amberchild/MPPT-Solar-Charger/Documents/MPPT_Charger_BOM_v1.xls

MPPT Charger BOM
Part Description | Designator | Value | Footprint | Specification | Quantity | Manufacturer | Manufacturer Part No. | Supplier | Supplier part number | Link
Ceramic Capacitor | C1, C2, C3, C4, C9, C13, C14, C15, C20, C21, C22, C23, C24, C25, C26, C28, C32 | 100nF | C0402 | X7R, 35V, 10% | 17 | TDK Corporation | CGA2B3X7R1V104K050BB | DigiKey | 445-6901-1-ND | https://www.digikey.com/product-detail/en/tdk-corporation/CGA2B3X7R1V104K050BB/445-6901-1-ND/2672919
Ceramic Capacitor | C5, C6, C10, C11, C33, C34, C35 | 22uF | C1210 | X5R, 35V, 20% | 7 | Taiyo Yuden | GMK325BJ226MM-P | DigiKey | 587-5853-1-ND | https://www.digikey.com/product-detail/en/taiyo-yuden/GMK325BJ226MM-P/587-5853-1-ND/7674973
Ceramic Capacitor | C7, C8, C12, C27, C29, C30, C36, C37, C38 | 4.7uF | C0805 | X5R, 35V, 10% | 9 | Murata Electronics | GRM219R6YA475KA73D | DigiKey | 490-7208-1-ND | https://www.digikey.com/product-detail/en/murata-electronics/GRM219R6YA475KA73D/490-7208-1-ND/3900454
Ceramic Capacitor | C16 | 22pF | C0402 | NPO, 50V, 5% | 1 | Yageo | CC0402JRNPO9BN220 | DigiKey | 311-1018-1-ND | https://www.digikey.com/product-detail/en/yageo/CC0402JRNPO9BN220/311-1018-1-ND/302935
Capacitor Tantalum | C17 | 47uF | EIA-7343-31 | TANT, 16V, 10% | 1 | AVX Corporation | TAJD476K016RNJ | DigiKey | 478-1739-1-ND | https://www.digikey.com/product-detail/en/avx-corporation/TAJD476K016RNJ/478-1739-1-ND/564771
Ceramic Capacitor | C18 | 4.7nF | C0402 | X7R, 50V, 10% | 1 | Yageo | AC0402KRX7R9BB472 | DigiKey | 311-3030-1-ND | https://www.digikey.com/product-detail/en/yageo/AC0402KRX7R9BB472/311-3030-1-ND/6643281
Ceramic Capacitor | C19 | 33pF | C0402 | NP0, 50V, 5% | 1 | Yageo | CC0402JRNPO9BN330 | DigiKey | 311-1020-1-ND | https://www.digikey.com/product-detail/en/yageo/CC0402JRNPO9BN330/311-1020-1-ND/302937
Ceramic Capacitor | C31 | 220nF | C0402 | X5R, 25V, 10% | 1 | Yageo | CC0402KRX5R8BB224 | DigiKey | 311-3341-1-ND | https://www.digikey.com/product-detail/en/yageo/CC0402KRX5R8BB224/311-3341-1-ND/6818311
TVS DIODE | D1 | SM6T30CAY | DO-214AA | 30V, 0.6kW | 1 | STMicroelectronics | SM6T30CAY | DigiKey | 497-10800-1-ND | https://www.digikey.com/product-detail/en/stmicroelectronics/SM6T30CAY/497-10800-1-ND/2442951
Small signal Schottky diode | D2 | BAT54KFILM | SOD-523 | 40V, 0.3A | 1 | STMicroelectronics | BAT54KFILM | DigiKey | 497-5561-1-ND | https://www.digikey.com/product-detail/en/stmicroelectronics/BAT54KFILM/497-5561-1-ND/1207053
DIODE SCHOTTKY | D3, D4 | DFLS2100-7 | PowerDI123 | 100V, 2A | 2 | Diodes Incorporated | DFLS2100-7 | DigiKey | DFLS2100-7DICT-ND | https://www.digikey.com/product-detail/en/diodes-incorporated/DFLS2100-7/DFLS2100-7DICT-ND/3451552
Low voltage Transil™ | D5 | SMLVT3V3 | DO-214AA | 3.3V, 0.6kW | 1 | STMicroelectronics | SMLVT3V3 | DigiKey | 497-2496-1-ND | https://www.digikey.com/product-detail/en/stmicroelectronics/SMLVT3V3/497-2496-1-ND/603878
Fast Acting Fuse | F1, F2 | 1206SFH100F/24-2 | F1206 | 100A | 2 | LITTELFUSE | 1206SFH100F/24-2 | Farnell | 1832124 | https://uk.farnell.com/littelfuse/1206sfh100f-24-2/fuse-1206-10a/dp/1832124
Micro USB Connector | J1 | MCR-B-S-RA-TSMT-CS4A-T/R | MCR-B-S-RA-TSMT-CS4A-T/R | Type B | 1 | ADAM TECH | MCR-B-S-RA-TSMT-CS4A-T/R | Rutronik | CONIO1874 | https://www.rutronik24.com/search-result/nojs:1337/qs:MCR-B-S-RA-TSMT-CS4A-T%252FR/reset:0
Power Inductor | L1 | 6.1uH | CDEP147 | 11A, 20% | 1 | Sumida America Components Inc. | CDEP147NP-6R1MC-95 | DigiKey | 308-1608-1-ND | https://www.digikey.com/product-detail/en/sumida-america-components-inc/CDEP147NP-6R1MC-95/308-1608-1-ND/3232383
Power Inductor | L2 | 10uH | LQH3NP | 0.8A, 20% | 1 | Murata Electronics | LQH3NPN100MMEL | DigiKey | 490-15945-1-ND | https://www.digikey.com/product-detail/en/murata-electronics/LQH3NPN100MMEL/490-15945-1-ND/6800610
Power Inductor | L3 | 4.7uH | LQH3NP | 1A, 20% | 1 | Murata Electronics | LQH3NPN4R7MMEL | DigiKey | 490-15954-1-ND | https://www.digikey.com/product-detail/en/murata-electronics/LQH3NPN4R7MMEL/490-15954-1-ND/6800619
BICOLOR LED RED/GREEN CLEAR | LED1 | LSG T67K-JL-1+HK-1 | PLCC-4 | SMT | 1 | OSRAM Opto Semiconductors Inc. | LSG T67K-JL-1+HK-1 | DigiKey | 475-3435-1-ND | https://www.digikey.com/product-detail/en/osram-opto-semiconductors-inc/LSG-T67K-JL-1-HK-1/475-3435-1-ND/7908051
ARDUINO STACKABLE HEADER KIT - R | P1 | PRT-11417 | HDR1X10 | 10 pos. 2,54mm | 1 | SparkFun Electronics | PRT-11417 | DigiKey | 1568-1413-ND | https://www.digikey.com/product-detail/en/sparkfun-electronics/PRT-11417/1568-1413-ND/6161755
Terminal block | P5, P9 | MSG02001 | TERM2pin5mm | 2pos. 5mm, 24A, 300V | 2 | SAURO | MSG02001 | Rutronik | COTERM5720 | https://www.sauro.net/products/MSG02001/?product_id=MSG02001
Terminal block | P6 | MSG04001 | TERM4pin5mm | 4 pos. 5mm, 24A, 300V | 1 | SAURO | MSG04001 | Rutronik | COTERM6351 | https://www.sauro.net/products/MSG04001/?product_id=MSG04001
P-channel Power MOSFET | Q1, Q2, Q4 | STL150N3LLH5 | PowerFLAT 5x6 | 30V, 35A | 3 | STMicroelectronics | STL150N3LLH5 | Farnell | 1752112RL | https://uk.farnell.com/stmicroelectronics/stl150n3llh5/mosfet-n-ch-30v-35a-powerflat6x5/dp/1752112RL
N-Channel MOSFET | Q3 | DMG1012T-7 | SOT-523_custom | 20V, 0.63A | 1 | Diodes Incorporated | DMG1012T-7 | DigiKey | DMG1012T-7DICT-ND | https://www.digikey.com/product-detail/en/diodes-incorporated/DMG1012T-7/DMG1012T-7DICT-ND/2181232
Thick Film Resistor | R1, R15, R16, R20, R21, R22 | 1K | R0402 | 5% 0,063W | 6 | Yageo | AC0402JR-071KL | DigiKey | YAG3525CT-ND | https://www.digikey.com/product-detail/en/yageo/AC0402JR-071KL/YAG3525CT-ND/6006374
Thick Film Resistor | R2 | 2R | R0805 | 5% 0.125W | 1 | Yageo | RC0805JR-072RL | DigiKey | 311-2.0ARCT-ND | https://www.digikey.com/product-detail/en/yageo/RC0805JR-072RL/311-2-0ARCT-ND/731214
Thick Film Resistor | R3 | 10R | R0805 | 5% 0.125W | 1 | Yageo | RC0805JR-07510RL | DigiKey | 311-510ARCT-ND | https://www.digikey.com/product-detail/en/yageo/RC0805JR-07510RL/311-510ARCT-ND/731290
Thick Film Resistor | R4 | 150K | R0402 | 5% 0,063W | 1 | Yageo | RC0402JR-07150KL | DigiKey | 311-150KJRCT-ND | https://www.digikey.com/product-detail/en/yageo/RC0402JR-07150KL/311-150KJRCT-ND/729372
Thick Film Resistor | R5, R11, R12, R14, R18, R19 | 100K | R0402 | 5% 0,063W | 6 | Yageo | RC0402JR-07100KL | DigiKey | 311-100KJRCT-ND | https://www.digikey.com/product-detail/en/yageo/RC0402JR-07100KL/311-100KJRCT-ND/729363
Thick Film Resistor | R6, R7 | R008 | R2010 | 1% 1W | 2 | Rohm Semiconductor | PMR50HZPFU8L00 | DigiKey | RHM.008ASCT-ND | https://www.digikey.com/product-detail/en/rohm-semiconductor/PMR50HZPFU8L00/RHM-008ASCT-ND/2094542
Thick Film Resistor | R8 | 560K | R0402 | 5% 0,063W | 1 | Yageo | RC0402JR-07560KL | DigiKey | 311-560KJRCT-ND | https://www.digikey.com/product-detail/en/yageo/RC0402JR-07560KL/311-560KJRCT-ND/729440
Thick Film Resistor | R9 | 11K | R0402 | 5% 0,063W | 1 | Yageo | RC0402JR-0711KL | DigiKey | 311-11KJRCT-ND | https://www.digikey.com/product-detail/en/yageo/RC0402JR-0711KL/311-11KJRCT-ND/729367
Thick Film Resistor | R10 | 10K | R0402 | 5% 0.03W | 1 | Yageo | RC0100JR-0710KL | DigiKey | 311-10KDHCT-ND | https://www.digikey.com/product-detail/en/yageo/RC0100JR-0710KL/311-10KDHCT-ND/2254412
Thick Film Resistor | R13 | 110K | R0402 | 5% 0,063W | 1 | Yageo | RC0402JR-07110KL | DigiKey | 311-110KJRCT-ND | https://www.digikey.com/product-detail/en/yageo/RC0402JR-07110KL/311-110KJRCT-ND/729366
Thick Film Resistor | R17 | 1M | R0402 | 1% 0,063W | 1 | Yageo | RC0402FR-071ML | DigiKey | 311-1.00MLRCT-ND | https://www.digikey.com/product-detail/en/yageo/RC0402FR-071ML/311-1-00MLRCT-ND/729462
Thick Film Resistor | R23 | 24.9K | R0402 | 1% 0,063W | 1 | Yageo | RC0402FR-0724K9L | DigiKey | 311-24.9KLRCT-ND | https://www.digikey.com/product-detail/en/yageo/RC0402FR-0724K9L/311-24-9KLRCT-ND/729514
Thick Film Resistor | R24 | 12K | R0402 | 5% 0,063W | 1 | Yageo | RC0402JR-0712KL | DigiKey | 311-12KJRCT-ND | https://www.digikey.com/product-detail/en/yageo/RC0402JR-0712KL/311-12KJRCT-ND/729370
Thick Film Resistor | R25, R26 | 100R | R0402 | 5% 0.125W | 2 | Yageo | SR0402JR-7W100RL | DigiKey | YAG6156CT-ND | https://www.digikey.com/product-detail/en/yageo/SR0402JR-7W100RL/YAG6156CT-ND/9696610
Thick Film Resistor | R27 | 6.8K | R0402 | 5% 0,063W | 1 | Yageo | RC0402JR-076K8L | DigiKey | 311-6.8KJRCT-ND | https://www.digikey.com/product-detail/en/yageo/RC0402JR-076K8L/311-6-8KJRCT-ND/729444
Thick Film Resistor | R28 | R62 | R1206 | 1% 0.25W | 1 | Panasonic Electronic Components | ERJ-8RQFR62V | DigiKey | P.62RCT-ND | https://www.digikey.com/product-detail/en/panasonic-electronic-components/ERJ-8RQFR62V/P-62RCT-ND/3982353
Thick Film Resistor | R29, R30, R31, R32 | 0R | R1206 | 0.25W | 4 | Yageo | RC1206JR-070RL | DigiKey | 311-0.0ERDKR-ND | https://www.digikey.com/product-detail/en/yageo/RC1206JR-070RL/311-0-0ERDKR-ND/735078
Tactile Button | S1, S2 | EVQPUJ02K | EVQPUA | 1.6N, Right Angle, 50mA | 2 | Panasonic | EVQPUJ02K | DigiKey | P10851SCT-ND | https://www.digikey.com/product-detail/en/panasonic-electronic-components/EVQ-PUJ02K/P10851SCT-ND/286352
SMT Test Point | TP4 | 5019 | 5019_keystone | 3.81*2.03 | 1 | Keystone Electronics | 5019 | DigiKey | 36-5019CT-ND | https://www.digikey.com/product-detail/en/keystone-electronics/5019/36-5019CT-ND/3907344
Current-Shunt Monitor | U1, U2 | NCS213RSQT2G | SOT-363 | x50, 80uA, 26V | 2 | ON Semiconductor | NCS213RSQT2G | DigiKey | NCS213RSQT2GOSCT-ND | https://www.digikey.com/product-detail/en/on-semiconductor/NCS213RSQT2G/NCS213RSQT2GOSCT-ND/9169239
Smart Diode Controller | U3 | LM74610QDGKRQ1 | TSSOP-8 | 42V, 30uA | 1 | TI | LM74610QDGKRQ1 | DigiKey | 296-43067-1-ND | https://www.digikey.com/product-detail/en/texas-instruments/LM74610QDGKRQ1/296-43067-1-ND/5722225
Battery Charge Controller | U4 | BQ24650RVAT | QFN-16_custom | 28V, MPPT | 1 | TI | BQ24650RVAR | DigiKey | 296-46287-1-ND | https://www.digikey.com/product-detail/en/texas-instruments/BQ24650RVAR/296-46287-1-ND/7033462
Ultra large bandwidth ESD protection | U5, U10 | USBULC6-2M6 | Micro_QFN_6L | 6V, 0.6pF | 2 | STMicroelectronics | USBULC6-2M6 | DigiKey | 497-7044-1-ND | https://www.digikey.com/product-detail/en/stmicroelectronics/USBULC6-2M6/497-7044-1-ND/1880382
Ultra-low-power 32-bit MCU Arm®-based Cortex®-M0+ | U6 | STM32L072KZT6 | LQFP32 | 192KB, 20KB, 1.65V-3.6V | 1 | STMicroelectronics | STM32L072KZT6 | DigiKey | 497-19668-ND | https://www.digikey.com/products/en?keywords=STM32L072KZT6
Boost LED DRiver | U7 | TPS61165DRVT | QFN-6_custom | 18V in, 38V, 350mA | 1 | TI | TPS61165DRVT | DigiKey | 296-27015-1-ND | https://www.digikey.com/product-detail/en/texas-instruments/TPS61165DRVT/296-27015-1-ND/2255302
Buck Switching Regulator | U8 | AP63205WU-7 | SOT23-6_custom | 32V in, 5V, 2A | 1 | Diodes Incorporated | AP63205WU-7 | DigiKey | AP63205WU-7DICT-ND | https://www.digikey.com/product-detail/en/diodes-incorporated/AP63205WU-7/AP63205WU-7DICT-ND/9858428
Linear Voltage Regulator | U9 | STLQ015M33R | SOT23-5L | 5.5V in, 3.3V, 150mA | 1 | STMicroelectronics | STLQ015M33R | DigiKey | 497-15934-1-ND | https://www.digikey.com/product-detail/en/stmicroelectronics/STLQ015M33R/497-15934-1-ND/5398723
