amberchild/MPPT-Solar-Charger/Documents/Schematics and Layout.PDF

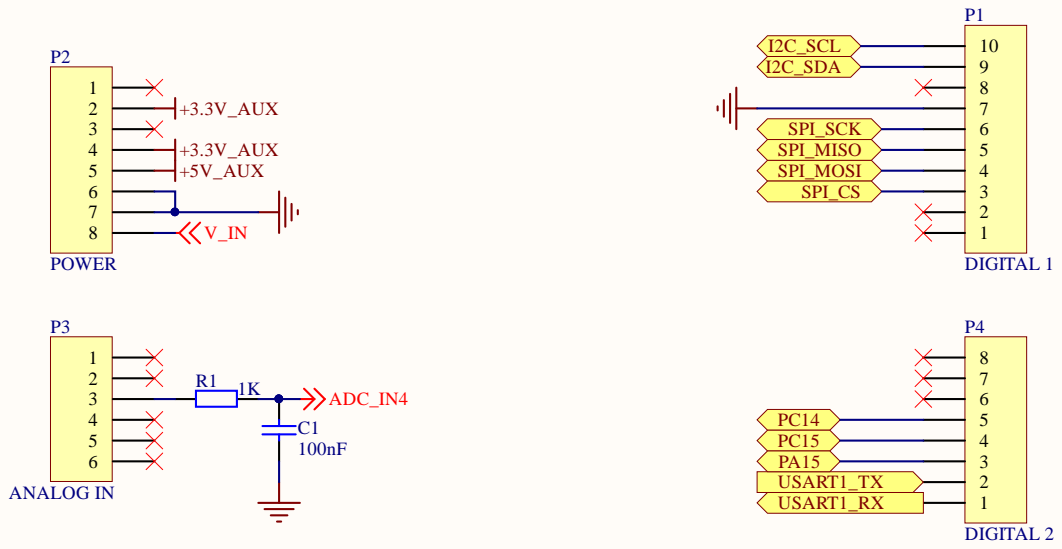
[picture p1: page 1]

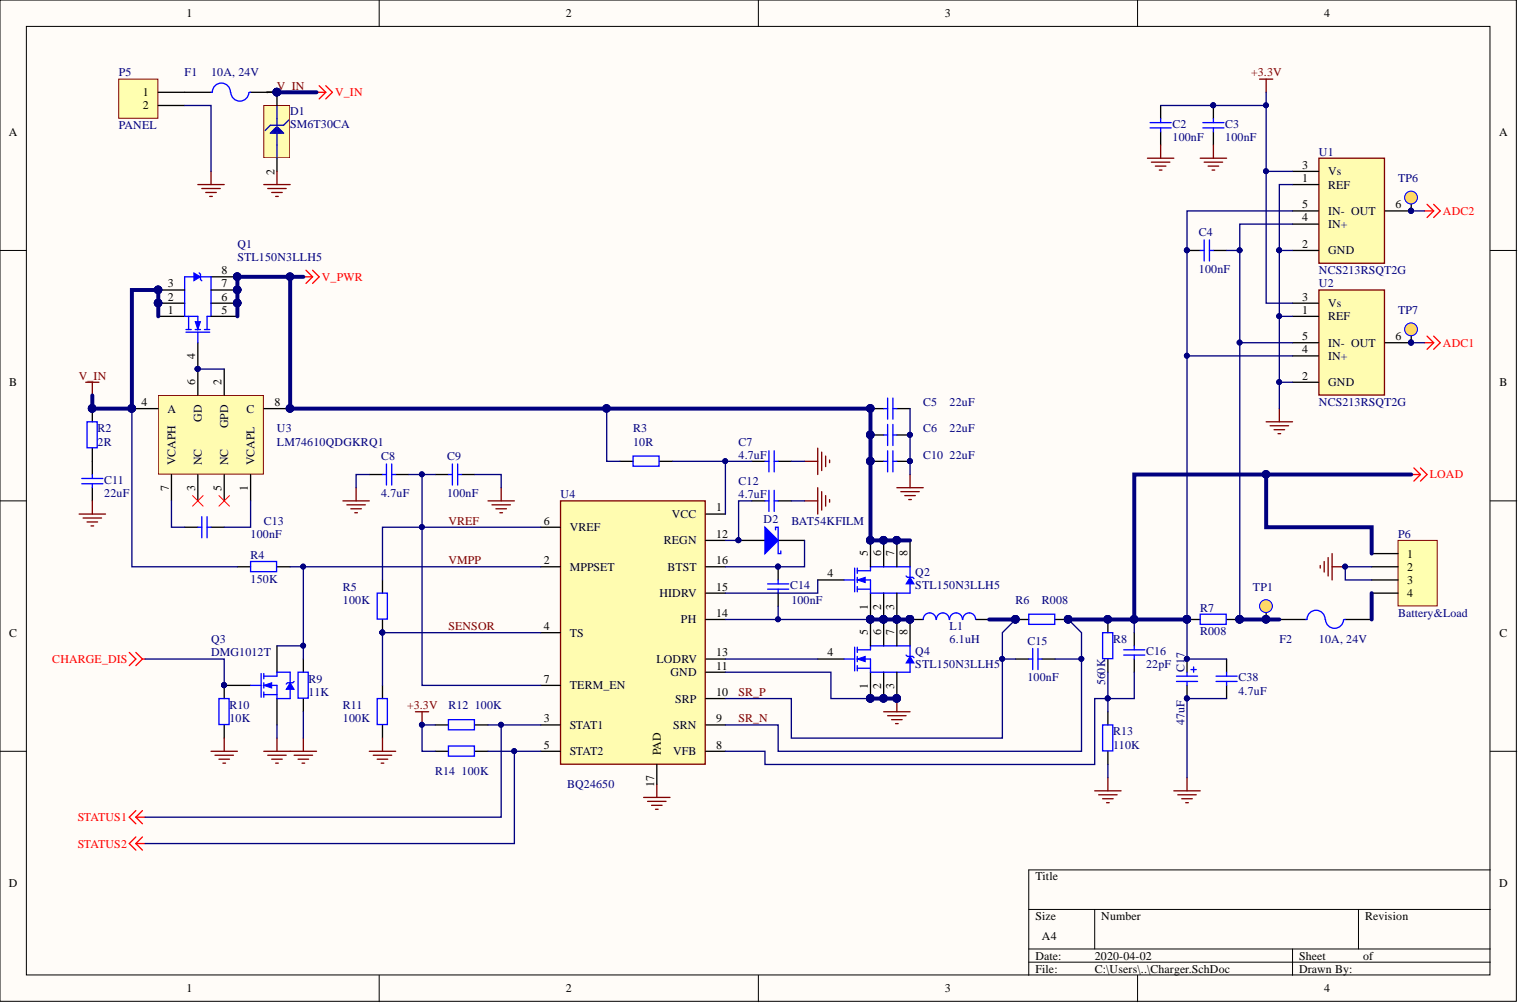
[picture p2: page 2]

VMPP | 2

SE NSO R | 4

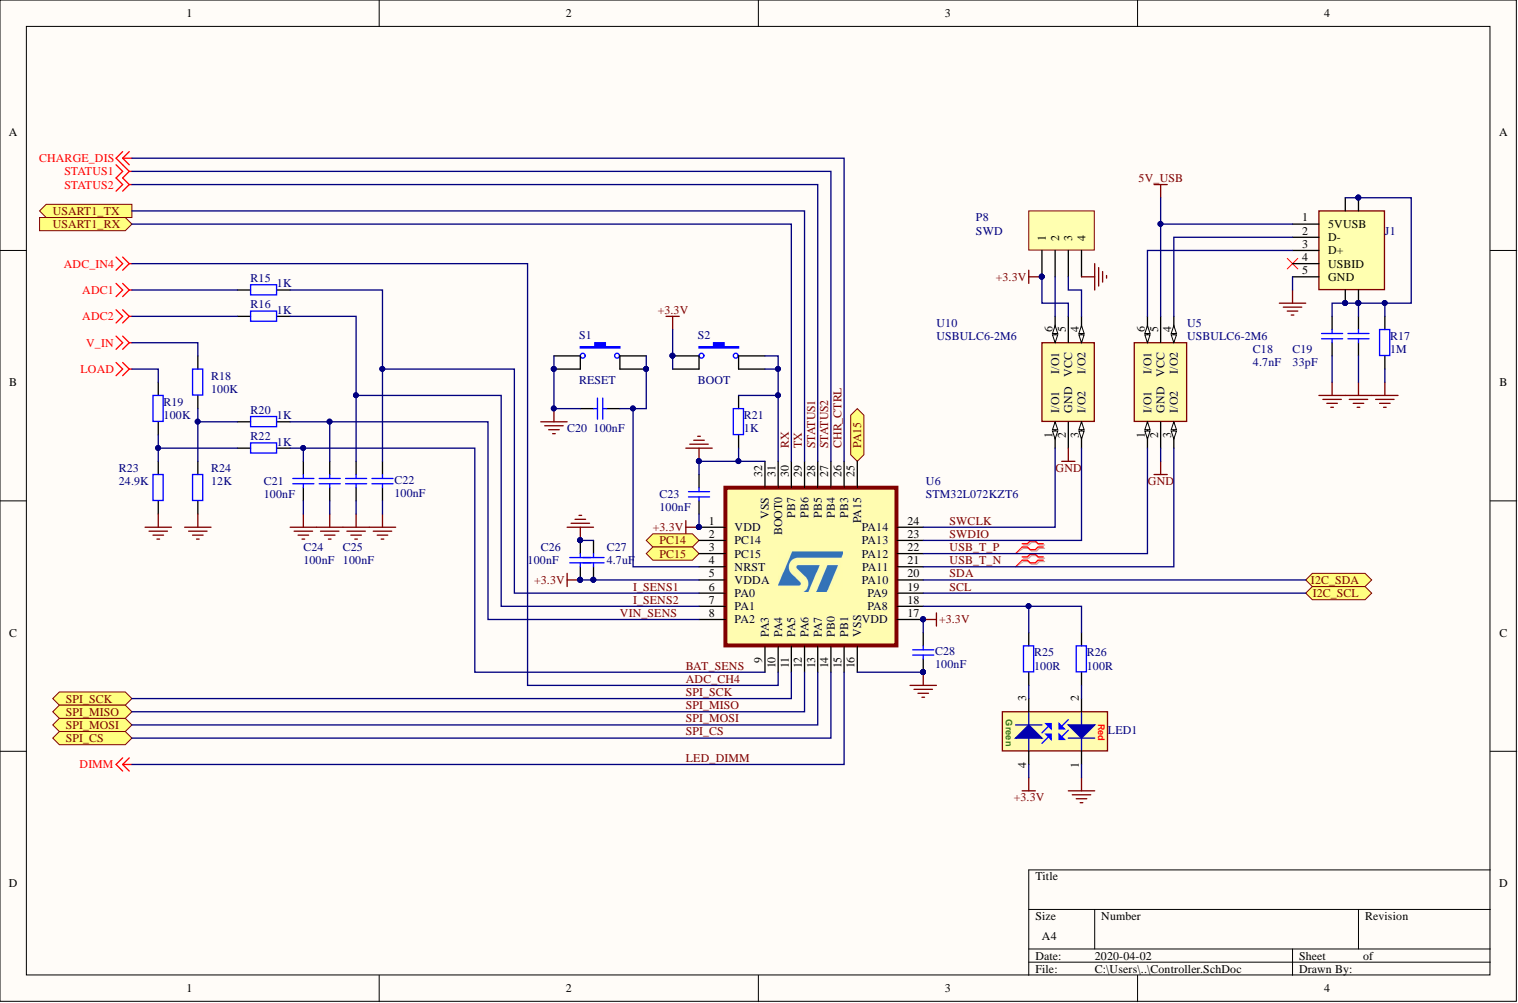
[picture p3: page 3]

U 6 STM3 2 L 0 7 2 K Z T 6 SWCL K

2 | 2 3 | SW DIO
3 | 2 2 | USB_ T _ P
4 | 2 1 | USB_ T _ N

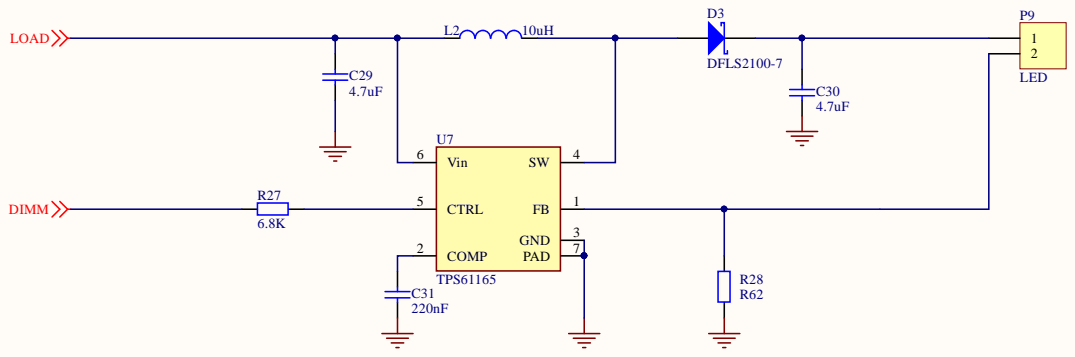
[picture p4: page 4]

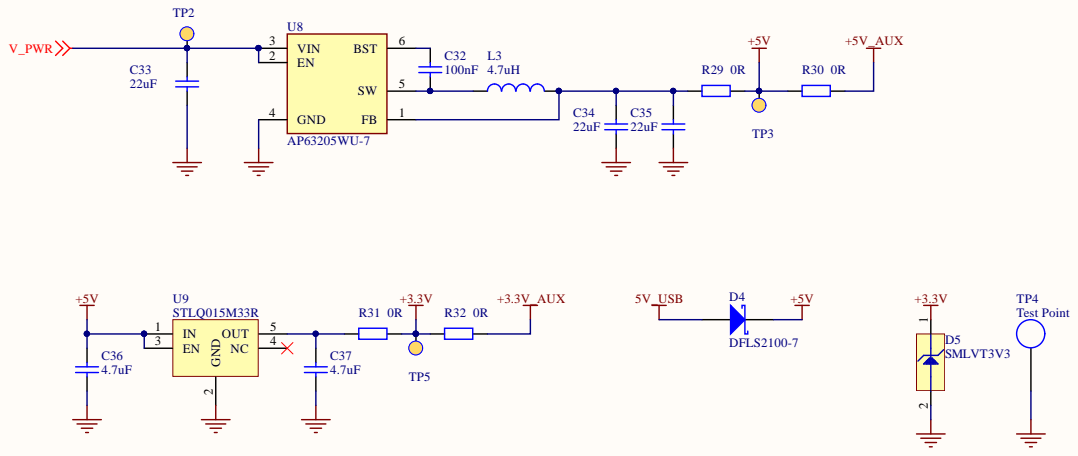
[picture p5: page 5]

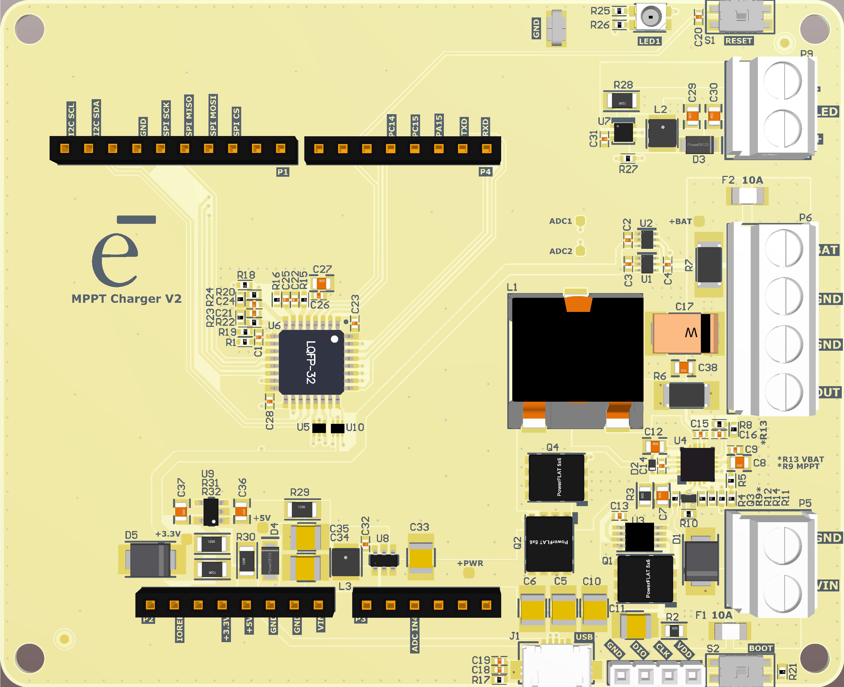
[picture p6: page 6]

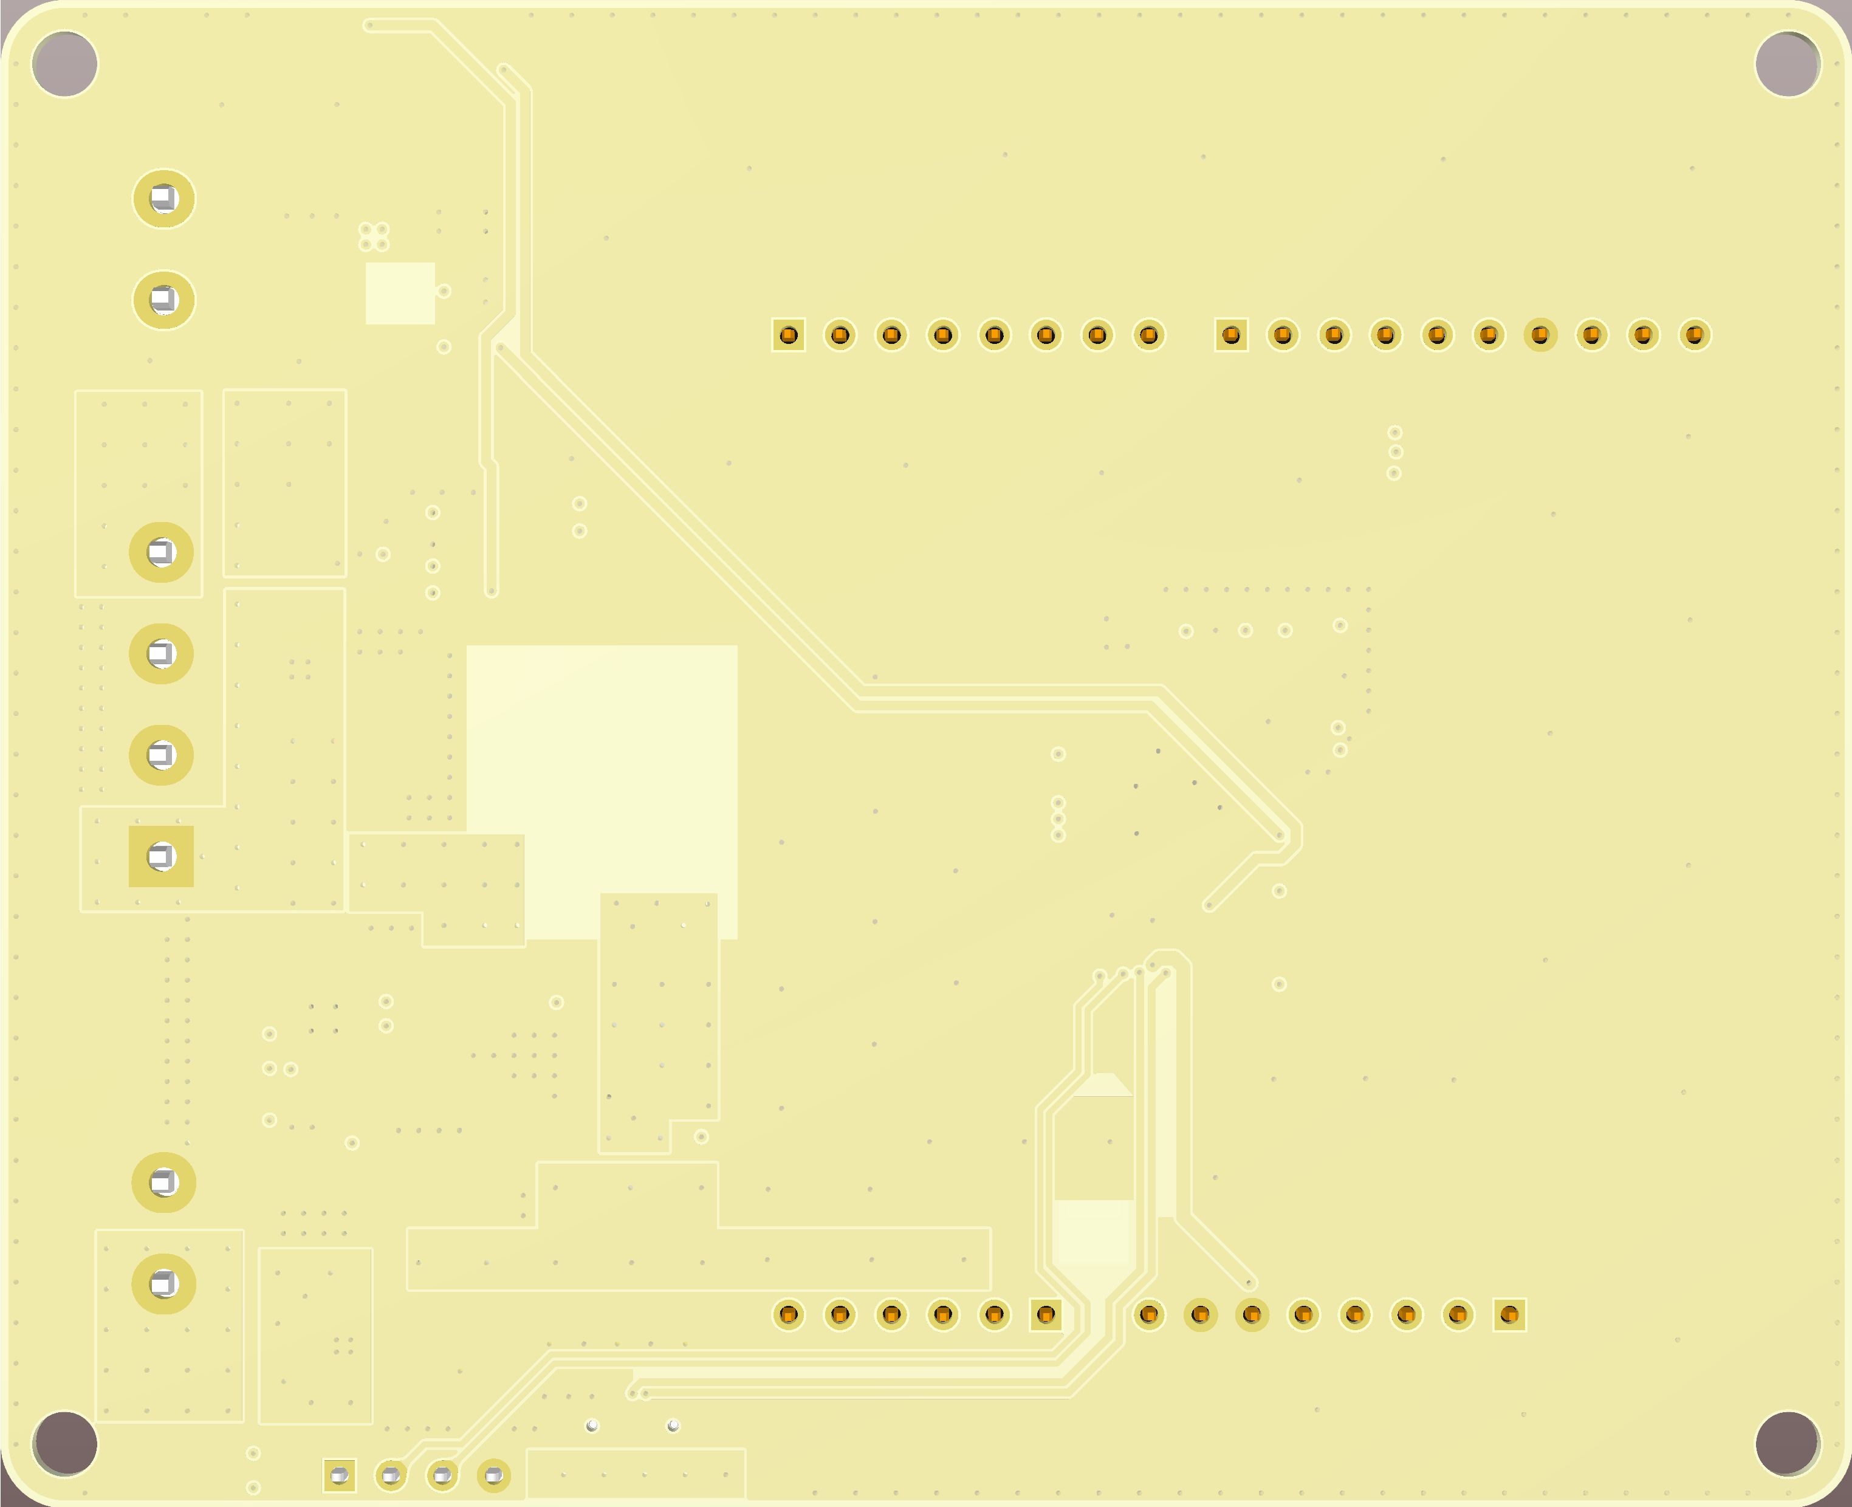
[picture p7: page 7]

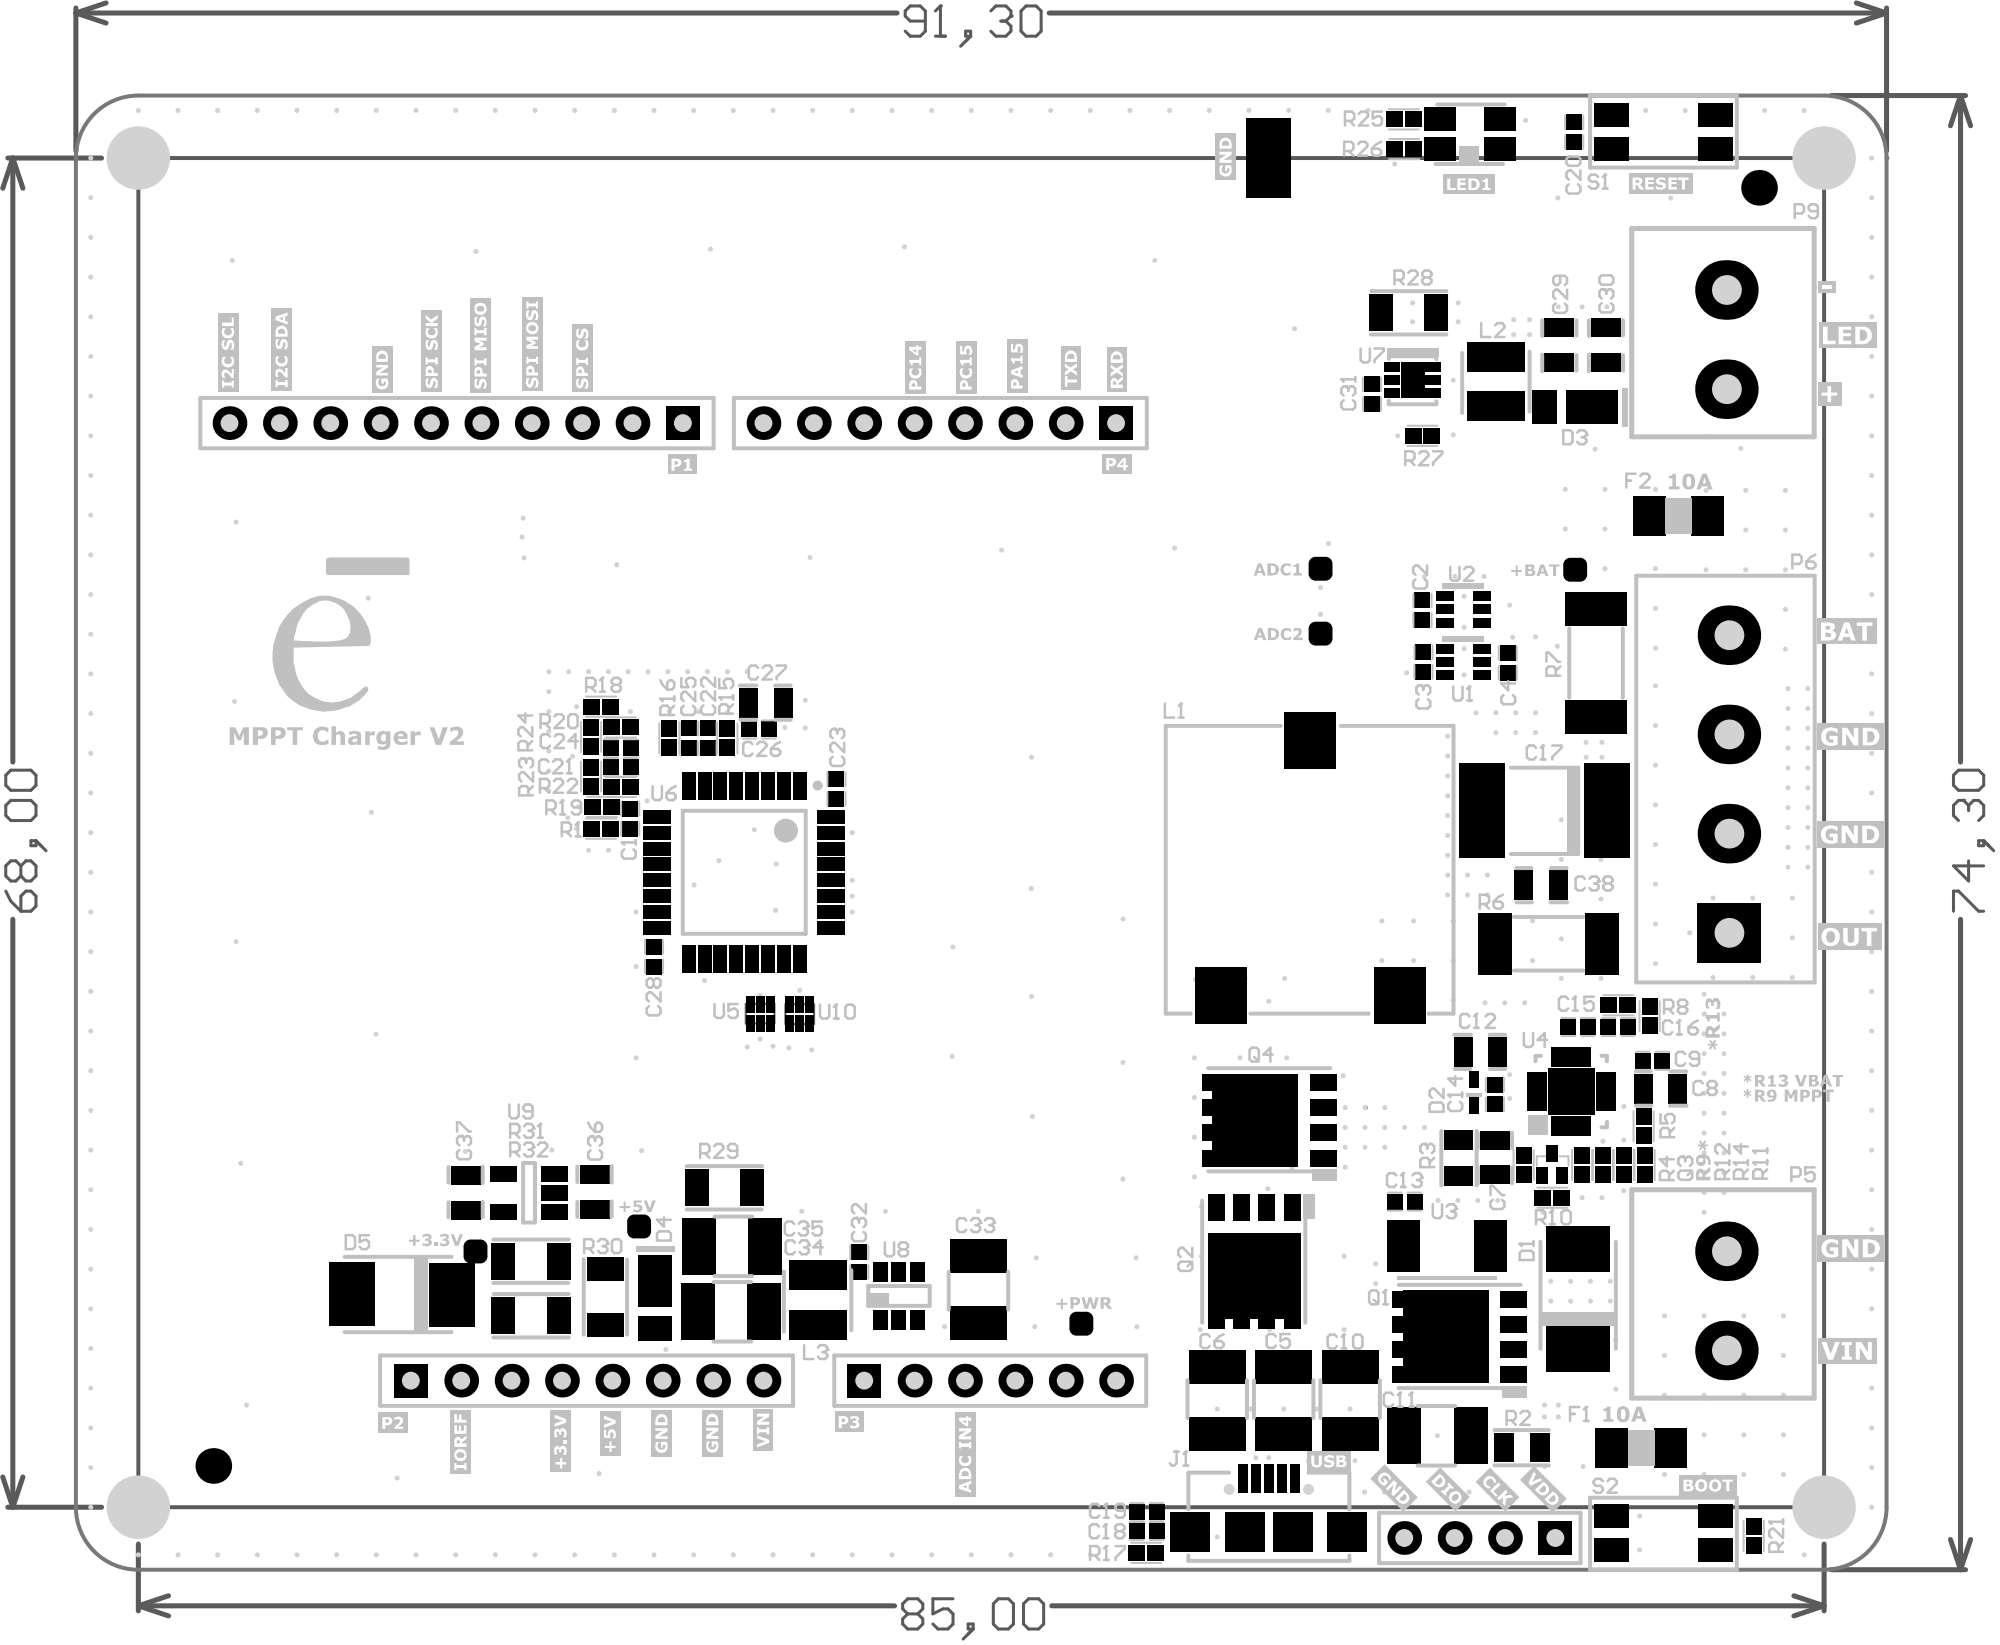
[picture p8: page 8]
