amberchild/MPPT-Solar-Charger/(list of files, drawings)

Other design files:
MPPT_Charger_NB_IoT/10118192-0001LF.PcbLib
MPPT_Charger_NB_IoT/AP63205WU-7.SchLib
MPPT_Charger_NB_IoT/Arduino.SchDoc
MPPT_Charger_NB_IoT/CDEP147.PcbLib
MPPT_Charger_NB_IoT/Charger.SchDoc
MPPT_Charger_NB_IoT/Controller.SchDoc
MPPT_Charger_NB_IoT/F1206.PcbLib
MPPT_Charger_NB_IoT/LED Driver.SchDoc
MPPT_Charger_NB_IoT/LM74610-Q1.SchLib
MPPT_Charger_NB_IoT/LQFP32.PcbLib
MPPT_Charger_NB_IoT/LQH3NP.PcbLib
MPPT_Charger_NB_IoT/MPPT_Charger.PcbLib
MPPT_Charger_NB_IoT/MPPT_Charger_NB_IoT.PrjPcb
MPPT_Charger_NB_IoT/NCS21xR.SchLib
MPPT_Charger_NB_IoT/Power.SchDoc
MPPT_Charger_NB_IoT/PowerDI123.PcbLib
MPPT_Charger_NB_IoT/PowerFLAT 5x6.PcbLib
MPPT_Charger_NB_IoT/QFN-6_custom.PcbLib
MPPT_Charger_NB_IoT/QFN-16_custom.PcbLib
MPPT_Charger_NB_IoT/SOT-363.PcbLib
MPPT_Charger_NB_IoT/STLQ015M33R.SchLib
MPPT_Charger_NB_IoT/STM32L072KZT6.SchLib
MPPT_Charger_NB_IoT/TSSOP-8.PcbLib
