amberchild/MPPT-Solar-Charger/Firmware/MPPT_LED/Src/main.c

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
/* Includes ------------------------------------------------------------------*/
#include "main.h"
#include "cmsis_os.h"

/* USER CODE BEGIN Includes */
#include "led_control_task.h"
#include "monitor_task.h"
#include "indication_task.h"
#include "management_task.h"
#include "eeprom.h"
#include "modem.h"
#include "StringCommandParser.h"
#include "string.h"
/* USER CODE END Includes */

ADC_HandleTypeDef hadc;
DMA_HandleTypeDef hdma_adc;

CRC_HandleTypeDef hcrc;

IWDG_HandleTypeDef hiwdg;

TIM_HandleTypeDef htim7;
TIM_HandleTypeDef htim21;
TIM_HandleTypeDef htim22;

UART_HandleTypeDef huart1;
DMA_HandleTypeDef hdma_usart1_rx;
DMA_HandleTypeDef hdma_usart1_tx;

osThreadId defaultTaskHandle;
/* USER CODE BEGIN PV */
EEPROMStorageTypDef eeprom_info;
uint8_t aRxBuffer;
/* USER CODE END PV */

void SystemClock_Config(void);
static void MX_CRC_Init(void);
static void MX_USART1_UART_Init(void);
static void MX_TIM7_Init(void);
static void MX_IWDG_Init(void);
void StartDefaultTask(void const * argument);

static void MX_NVIC_Init(void);
/**
  * @brief  The application entry point.
  * @retval int
  */
int main(void)
{
  /* MCU Configuration--------------------------------------------------------*/

  /* Reset of all peripherals, Initializes the Flash interface and the Systick. */
  HAL_Init();

  /* Configure the system clock */
  SystemClock_Config();

  /* Initialize all configured peripherals */
  MX_GPIO_Init();
  MX_DMA_Init();
  MX_ADC_Init();
  MX_TIM22_Init();
  MX_TIM21_Init();
  MX_CRC_Init();
  MX_USART1_UART_Init();
  MX_TIM7_Init();
  MX_IWDG_Init();

  /* Initialize interrupts */
  MX_NVIC_Init();
  /* USER CODE BEGIN 2 */

  /*Read saved data from EEPROM*/
  eeprom_ram_init(&eeprom_info);
  eeprom_save(&eeprom_info);

  /*Feed the watchdog timer*/
  HAL_IWDG_Refresh(&hiwdg);

  /*AT parser initialisation*/
 SCP_Init(uart_send_buff, uart_read_byte);

 /*Reset AT Parser rx buffer */
 SCP_InitRx();

 /*AT Callbacks Register*/

  /* USER CODE END 2 */

  /* USER CODE BEGIN RTOS_MUTEX */
  /* add mutexes, ... */
  /* USER CODE END RTOS_MUTEX */

  /* USER CODE BEGIN RTOS_SEMAPHORES */
  /* add semaphores, ... */
  /* USER CODE END RTOS_SEMAPHORES */

  /* USER CODE BEGIN RTOS_TIMERS */
  /* start timers, add new ones, ... */
  /* USER CODE END RTOS_TIMERS */

  /* USER CODE BEGIN RTOS_QUEUES */
  led_msg = osMessageCreate (&led_msg_def, LEDControlTaskHandle);
  ind_msg = osMessageCreate (&ind_msg_def, IndicationTaskHandle);
  /* USER CODE END RTOS_QUEUES */

  /* Create the thread(s) */
  /* definition and creation of defaultTask */
  osThreadDef(defaultTask, StartDefaultTask, osPriorityNormal, 0, 64);
  defaultTaskHandle = osThreadCreate(osThread(defaultTask), NULL);

  /* USER CODE BEGIN RTOS_THREADS */

  /* LED Control Task */
  osThreadDef(ledcontrol, LEDControlTask, osPriorityAboveNormal, 0, 64);
  LEDControlTaskHandle = osThreadCreate(osThread(ledcontrol), NULL);

  /* Monitoring Task */
  osThreadDef(monitoring, MonitorTask, osPriorityHigh, 0, 64);
  MonitorTaskHandle = osThreadCreate(osThread(monitoring), NULL);

  /* Indication Task */
  osThreadDef(indication, IndicationTask, osPriorityAboveNormal, 0, 64);
  IndicationTaskHandle = osThreadCreate(osThread(indication), NULL);

  /* Management Task */
  osThreadDef(management, ManagementTask, osPriorityNormal, 0, 1024);
  ManagementTaskHandle = osThreadCreate(osThread(management), NULL);

  /* USER CODE END RTOS_THREADS */

  /* Start scheduler */
  osKernelStart();

  /* We should never get here as control is now taken by the scheduler */
  /* Infinite loop */
  /* USER CODE BEGIN WHILE */
  while (1)
  {
    /* USER CODE END WHILE */

    /* USER CODE BEGIN 3 */
  }
  /* USER CODE END 3 */
}

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
/* USER CODE BEGIN 4 */
void eeprom_ram_init(EEPROMStorageTypDef *eeprom)
{
	uint32_t crc;

	/*Copy data from EEPROM*/
	memcpy(eeprom, (uint32_t*)EEPROM_BASE_ADDRESS, sizeof(EEPROMStorageTypDef));

	/*Calculate the CRC*/
	crc = HAL_CRC_Calculate(&hcrc, (uint32_t *)eeprom, sizeof(EEPROMStorageTypDef)-sizeof(uint32_t));

	/*Initialize defaults if CRC is wrong*/
	if(crc != eeprom->crc)
	{
		eeprom->batt_full_mah = FULL_BATT_MAH;
		eeprom->batt_full_mv = FULL_BATT_MV;
		eeprom->batt_low_mv = BATT_LOW_MV;
		eeprom->vin_hys_mv = VINPUT_HYS;
		eeprom->vin_limit_mv = VINPUT_LIMIT;
		eeprom->total_batt_ouput_ah = 0;
	}
	else
	{
		storage.total_batt_ouput_ah = eeprom->total_batt_ouput_ah;
	}
}

void eeprom_save(EEPROMStorageTypDef *eeprom)
{
	uint32_t crc;

	/*Calculate the CRC*/
	crc = HAL_CRC_Calculate(&hcrc, (uint32_t *)eeprom, sizeof(EEPROMStorageTypDef)-sizeof(uint32_t));

	if(eeprom->crc != crc)
	{
		eeprom->crc = crc;

		/*Write to EEPROM*/
		writeEEPROMData(0, (uint8_t*)eeprom, sizeof(EEPROMStorageTypDef));
	}
}

void HAL_UART_RxCpltCallback(UART_HandleTypeDef *huart)
{
  if(huart->Instance == USART1)
  {
    /*Byte received, forward to AT parser*/
    SCP_ByteReceived(aRxBuffer);
  }
}

/* USER CODE END 4 */

/* USER CODE BEGIN Header_StartDefaultTask */
/**
  * @brief  Function implementing the defaultTask thread.
  * @param  argument: Not used 
  * @retval None
  */
/* USER CODE END Header_StartDefaultTask */
void StartDefaultTask(void const * argument)
{
  /* USER CODE BEGIN 5 */
  /* Infinite loop */
  for(;;)
  {
    osDelay(1);
  }
  /* USER CODE END 5 */
}

/**
  * @brief  Period elapsed callback in non blocking mode
  * @note   This function is called  when TIM2 interrupt took place, inside
  * HAL_TIM_IRQHandler(). It makes a direct call to HAL_IncTick() to increment
  * a global variable "uwTick" used as application time base.
  * @param  htim : TIM handle
  * @retval None
  */
void HAL_TIM_PeriodElapsedCallback(TIM_HandleTypeDef *htim)
{
  if (htim->Instance == TIM2) {
    HAL_IncTick();
  }
  /* USER CODE BEGIN Callback 1 */
  if (htim->Instance == TIM21)
  {
	  osSignalSet (MonitorTaskHandle, 0x00000001);
  }

  if (htim->Instance == TIM7)
  {
	  SCP_Tick(10);
  }

  /* USER CODE END Callback 1 */
}

/**
  * @brief  This function is executed in case of error occurrence.
  * @retval None
  */
void Error_Handler(void)
{
  /* USER CODE BEGIN Error_Handler_Debug */
  /* User can add his own implementation to report the HAL error return state */

  /* USER CODE END Error_Handler_Debug */
}

#ifdef  USE_FULL_ASSERT
/**
  * @brief  Reports the name of the source file and the source line number
  *         where the assert_param error has occurred.
  * @param  file: pointer to the source file name
  * @param  line: assert_param error line source number
  * @retval None
  */
void assert_failed(uint8_t *file, uint32_t line)
{
  /* USER CODE BEGIN 6 */
  /* User can add his own implementation to report the file name and line number,
     tex: printf("Wrong parameters value: file %s on line %d\r\n", file, line) */
  /* USER CODE END 6 */
}
#endif /* USE_FULL_ASSERT */
