amberchild/MPPT-Solar-Charger/Firmware/MPPT_LED/Inc/main.h

#define ISENS1_Pin GPIO_PIN_0
#define ISENS1_GPIO_Port GPIOA
#define ISENS2_Pin GPIO_PIN_1
#define ISENS2_GPIO_Port GPIOA
#define VINPUT_Pin GPIO_PIN_2
#define VINPUT_GPIO_Port GPIOA
#define VBAT_Pin GPIO_PIN_3
#define VBAT_GPIO_Port GPIOA
#define VAUX_Pin GPIO_PIN_4
#define VAUX_GPIO_Port GPIOA
#define WAKE_Pin GPIO_PIN_5
#define WAKE_GPIO_Port GPIOA
#define LDO_OFF_Pin GPIO_PIN_6
#define LDO_OFF_GPIO_Port GPIOA
#define RESET_Pin GPIO_PIN_7
#define RESET_GPIO_Port GPIOA
#define LDO_OK_Pin GPIO_PIN_0
#define LDO_OK_GPIO_Port GPIOB
#define LED_CTRL_Pin GPIO_PIN_1
#define LED_CTRL_GPIO_Port GPIOB
#define LED_IND_Pin GPIO_PIN_8
#define LED_IND_GPIO_Port GPIOA
#define VMON_CLK_Pin GPIO_PIN_15
#define VMON_CLK_GPIO_Port GPIOA
#define CHR_CTRL_Pin GPIO_PIN_3
#define CHR_CTRL_GPIO_Port GPIOB
#define STAT2_Pin GPIO_PIN_4
#define STAT2_GPIO_Port GPIOB
#define STAT1_Pin GPIO_PIN_5
#define STAT1_GPIO_Port GPIOB
