amberchild/MPPT-Solar-Charger/Firmware/MPPT_LED/Src/management_task.c

/*
 * management_task.c
 *
 *  Created on: May 12, 2020
 *      Author: Gintaras
 */

#include "management_task.h"
#include "led_control_task.h"
#include "monitor_task.h"
#include "indication_task.h"
#include "modem.h"
#include "StringCommandParser.h"

osThreadId ManagementTaskHandle;

void ManagementTask(void const * argument)
{
	ch_state_t ch_status = UNKNOWN;
	static _Bool battery_charged = 0;
	static _Bool discharge_lock = 0;
	//static int32_t max_idle_current = 0;
	uint8_t i;
	upload_error_t sts = UPLOAD_OK;

	for(;;)
	{
		osDelay(1000);

		/*Check if it is a day time*/
		if(storage.daytime_flag)
		{
			/*If input is more than MPPT, enable the charger*/
			if(storage.vinput_mv+100 > MPPT_MV)
			{
				charger_enable();
				osDelay(5000);
				ch_status = charger_status();

				/*Stay in here until fully charged or the day is over:*/
				/*the charger should always indicate charge process termination*/
				while(ch_status == IN_PROGRESS)
				{
					osDelay(500);
					osMessagePut(ind_msg, IND_RED, osWaitForever);
					osDelay(500);
					osMessagePut(ind_msg, IND_GREEN, osWaitForever);
					discharge_lock = 0;
					battery_charged = 0;
					ch_status = charger_status();
					if(!storage.daytime_flag)/*Fail-safe*/
					{break;}
				}

				/*If battery is full, then it must have it's declared capacity (assumption)*/
				if(ch_status == COMPLETED)
				{
					battery_charged = 1;
					discharge_lock = 0;
					osMessagePut(ind_msg, IND_GREEN, osWaitForever);
					storage.energy_stored_mah = eeprom_info.batt_full_mah;
				}
				else
				{
					/*Undefined state. Restart the charger.*/
					charger_disable();
					osDelay(5000);
					for(i = 0; i < 4; i++)
					{
						osMessagePut(ind_msg, IND_RED, osWaitForever);
						osDelay(100);
						osMessagePut(ind_msg, IND_OFF, osWaitForever);
						osDelay(100);
					}
					charger_enable();
					osDelay(5000);
				}

			}
			/*If input is less than MPPT, disable charger*/
			else if(storage.vinput_mv-100 < MPPT_MV)
			{
				charger_disable();
				if(battery_charged)
				{
					for(i = 0; i < 4; i++)
					{
						osMessagePut(ind_msg, IND_GREEN, osWaitForever);
						osDelay(100);
						osMessagePut(ind_msg, IND_OFF, osWaitForever);
						osDelay(100);
					}
				}
				else
				{
					osMessagePut(ind_msg, IND_OFF, osWaitForever);
				}
			}

		}
		/*It must be a night time or PV module is disconnected*/
		else
		{
			charger_disable();
			osMessagePut(ind_msg, IND_OFF, osWaitForever);
			osMessagePut(led_msg, 0, osWaitForever);

			if(!discharge_lock)
			{
				/*Load the battery with LEDs*/
				if(battery_charged)
				{
					storage.led_level = load_setup(eeprom_info.batt_full_mah, HOURS_24 - storage.daylength_s);
				}
				else
				{
					storage.energy_stored_mah -= storage.energy_released_mah;
					storage.energy_released_mah = 0;
					if(storage.energy_stored_mah > 0)
					{
						storage.led_level = load_setup(storage.energy_stored_mah, HOURS_24 - storage.daylength_s);
					}
					else
					{
						storage.energy_stored_mah = 0;
						storage.led_level = 0;
						osMessagePut(led_msg, 0, osWaitForever);
					}
				}

				/*Discharge battery with LEDs*/
				modem_data.day_lenght_store = storage.daylength_s;
				storage.daylength_s = 0;
				while(1)
				{
					if(storage.led_level)
					{
						osMessagePut(ind_msg, IND_GREEN, osWaitForever);
						osDelay(500);
						osMessagePut(ind_msg, IND_OFF, osWaitForever);
						osDelay(500);
					}
					else
					{
						osMessagePut(ind_msg, IND_RED, osWaitForever);
						osDelay(50);
						osMessagePut(ind_msg, IND_OFF, osWaitForever);
						osDelay(950);
					}

					/*Day time?*/
					if(storage.daytime_flag)
					{
						break;
					}

					/*Low battery voltage?*/
					if(storage.vbatt_mv < BATT_LOW_MV)
					{
						discharge_lock = 1;
						break;
					}
				}

				/*End discharge process*/
				osMessagePut(led_msg, 0, osWaitForever);
				osMessagePut(ind_msg, IND_OFF, osWaitForever);
				eeprom_info.total_batt_ouput_ah = storage.total_batt_ouput_ah;
				eeprom_save(&eeprom_info);
				if(storage.vbatt_mv > BATT_LOW_MV - 500)
				{
					for(i = 0; i < 5; i++)
					{
						sts = TelitCloudUpload();
						if(sts == UPLOAD_OK)
						{break;}
						if(sts == MODEM_NO_OPERATOR_PRESENT)
						{break;}
					}
				}
				battery_charged = 0;
				storage.energy_stored_mah = 0;
				storage.energy_released_mah = 0;
			}
		}

		/*Energy bleed check in idle state*/
		/*
		if(battery_charged)
		{
			if(storage.coutput_ma > max_idle_current)
			{
				max_idle_current = storage.coutput_ma;
			}
			if(max_idle_current > IDLE_CURR_MA)
			{
				max_idle_current = 0;
				battery_charged = 0;
			}
			if(storage.energy_released_mah > IDLE_CURR_MAH)
			{
				battery_charged = 0;
			}
		}
		*/
	}
}

void charger_enable(void)
{
	HAL_GPIO_WritePin(CHR_CTRL_GPIO_Port, CHR_CTRL_Pin, GPIO_PIN_RESET);
}
void charger_disable(void)
{
	HAL_GPIO_WritePin(CHR_CTRL_GPIO_Port, CHR_CTRL_Pin, GPIO_PIN_SET);
}

ch_state_t charger_status(void)
{
	_Bool stat1;
	_Bool stat2;

	/*Read STAT1 pin*/
	if(HAL_GPIO_ReadPin(STAT1_GPIO_Port, STAT1_Pin) == GPIO_PIN_RESET)
		{stat1 = 0;}
	else
		{stat1 = 1;}

	/*Read STAT2 pin*/
	if(HAL_GPIO_ReadPin(STAT2_GPIO_Port, STAT2_Pin) == GPIO_PIN_RESET)
		{stat2 = 0;}
	else
		{stat2 = 1;}

	/*Decode logic*/
	if(stat1 && !stat2)
	{
		return IN_PROGRESS;
	}
	if(!stat1 && stat2)
	{
		return COMPLETED;
	}
	if(!stat1 && !stat2)
	{
		return INACTIVE;
	}

	return UNKNOWN;
}

uint32_t load_setup(uint32_t capacity, uint32_t nightitme)
{
	uint32_t intensity;
	uint32_t mAseconds;
	float capfix;

	capfix = 0.70 * capacity;
	capacity = (uint32_t)capfix;
	if(capfix  < 0)
	{
		intensity = 0;
		osMessagePut(led_msg, intensity, osWaitForever);
		return intensity;
	}

	/*Convert capacity to mAs*/
	mAseconds = capacity*3600;

	/*Look for load to have LEDs operational over night time*/
	for(intensity = 0; intensity < 32; intensity++)
	{
		osMessagePut(led_msg, intensity, osWaitForever);
		osDelay(300);
		if(storage.coutput_ma*nightitme > mAseconds)
		{
			osMessagePut(led_msg, intensity-1, osWaitForever);
			return intensity-1;
		}
	}

	return intensity;
}
