amberchild/MPPT-Solar-Charger/(commit log)

2020-04-04 Whole working directory commit.
    [10118192-0001LF.PcbLib, AP63205WU-7.SchLib, Arduino.SchDoc, CDEP147.PcbLib, Charger.SchDoc, Controller.SchDoc, F1206.PcbLib, LED Driver.SchDoc]
2020-05-10 Firmware folder added.
    [MPPT_LED.cfg]
2020-05-16 First working prototype.
2020-06-05 Improvements and bugfixes. Tested.
    [main.c, main.h, management_task.c, management_task.h, modem.c, modem.h, monitor_task.c, monitor_task.h]
2020-07-06 Stored energy will be equal to the capacity of the battery under fully charged condition.
2021-11-17 migrated to 1.7 IDE, Telit cloud bugfixes
    [MPPT_LED.ioc, led_control_task.c, main.c, main.h, management_task.c, modem.c, modem.h, monitor_task.c]
2021-11-20 Restarting the charging if error suspected.
    [management_task.c]
2021-12-15 Minor battery loading adjustments.
